paypaaul/Dumb-E/tools/README.md

# Tools

Strumenti lato PC. Previsto per la Fase 2: una CLI Python (pyserial) che parla il
[protocollo seriale](../docs/protocol.md) per script, sequenze e calibrazione.
