paypaaul/Dumb-E/hardware/pcb/SCH_Schematic1_2026-09-24.pdf

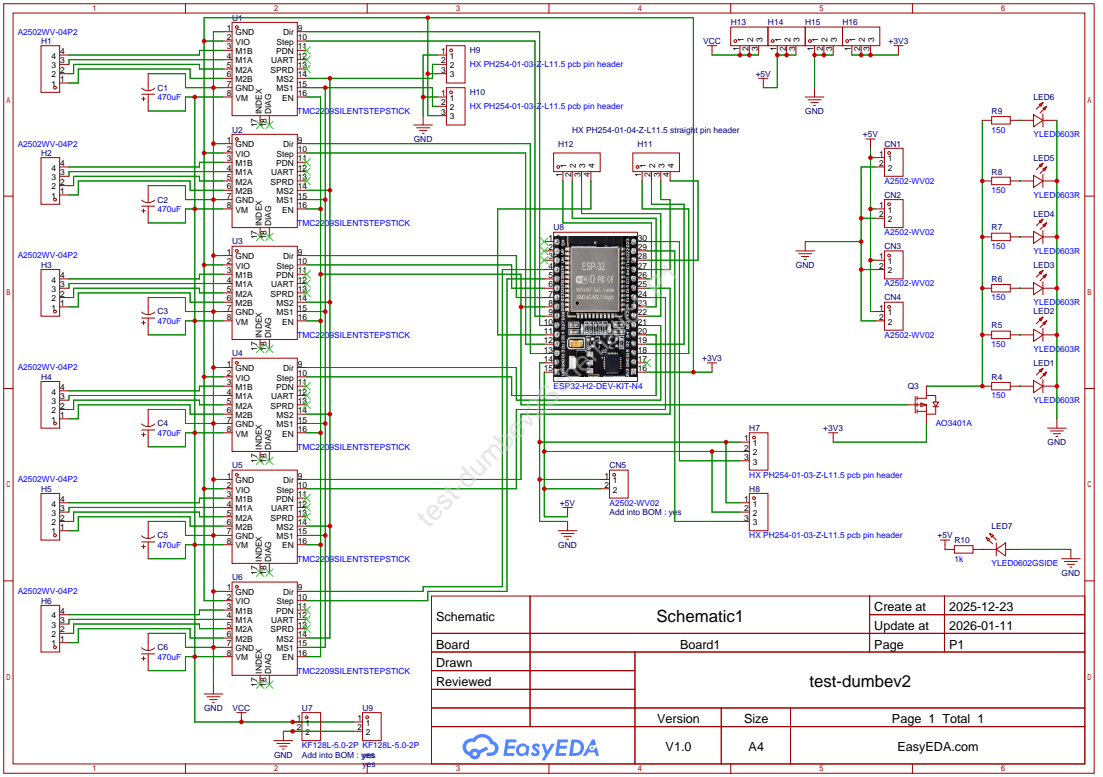
[picture p2: page 1]

HX PH254-01-04-Z-L11.5 straight pin header

Schematic | Schematic1 | Create at | 2025-12-23

Update at | 2026-01-11

Board | Board1 | Page | P1
Drawn | | test-dumbev2
Reviewed

Version | Size | Page 1 Total 1
V1.0 | A4 | EasyEDA.com
