paypaaul/Dumb-E/(list of files, drawings)

Other design files:
hardware/pcb/Board1.epro
