paypaaul/Dumb-E/(commit log)

2026-09-24 Restructure into monorepo and pin the toolchain
    - Move the ESP-IDF project into firmware/ to make room for hardware/, tools/ and docs/.
    - Drop .DS_Store and personal VS Code settings; ignore them from now on.
    - Require CMake 3.22 as the IDF 6 template does, rename the project to dumb_e
    (version comes from git describe) and enable MINIMAL_BUILD.
    - Add sdkconfig.defaults (240 MHz, 4 MB flash, 1 kHz tick, cache-safe GPTimer ISR).
    - Pin the devcontainer to espressif/idf:v6.0.3.
    - Add .clangd pointing at firmware/build, .clang-format and .editorconfig.
    - Add CI: host unit tests and firmware build with ESP-IDF v6.0.3.
2026-09-24 Add pure-C kinematics, motion profiles and step DDA with host tests
    - kinematics: 5-DOF model (base yaw, shoulder, elbow, wrist pitch, wrist roll),
    closed-form FK/IK with explicit elbow up/down, tool length, joint limits,
    singularity/unreachable detection, joint<->step mapping with rounding.
    Units are mm and radians throughout.
    - motion_profile: closed-form trapezoidal/triangular profiles on a path
    parameter, controlled stop, and synchronised limits for multi-joint moves.
    - stepgen_dda: integer-only DDA producing exactly n evenly spaced steps per
    segment; segment_ring: lock-free SPSC ring with C11 atomics.
    - Host test suite (CMake + Unity v2.6.1) covering all of the above.
2026-09-24 Replace the prototype firmware with the layered motion stack
    - stepgen: GPTimer step ISR (40 kHz) allocated on core 1, integer-only,
    cache-safe (IRAM), single-register STEP writes, guaranteed pulse width,
    DIR written one tick ahead, lock-free segment queue, stats and a tick
    watchdog that re-arms the timer if an alarm is ever lost.
    - motion: 1 kHz planner task on core 1 woken by the ISR; synchronised
    trapezoidal joint moves (all joints start and stop together), queued
    commands, controlled stop along the path, abort with resync.
    - robot: DISABLED/ENABLED/READY/ESTOP state machine, manual reference
    (zero at park pose), soft limits, jog, park, optional e-stop input,
    status LED; mec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
    [board.c, board.h, comms.c, comms.h, gripper.c, gripper.h, main.c]
2026-09-24 Add project documentation
    README with build/test instructions and quick start; docs for the
    architecture, serial protocol v0, kinematics conventions and parameters
    to measure, bring-up and bench tests, roadmap, and the review of the
    original prototype. Placeholders for hardware/ and tools/.
2026-09-24 Uploaded PCB files
    [Board1.epro]
2026-09-24 Adopt the test-dumbev2 PCB pinout and add its review
    - board: pin map of the carrier PCB with a DOIT ESP32 DevKit V1 (30 pin):
    J1..J5 on drivers U1..U5, EN on GPIO25, gripper servo on H7 (GPIO23).
    U6 is unusable (STEP/DIR routed to input-only GPIO35/34).
    - stepgen: STEP pins may now be any output GPIO, including 32/33 (U3 STEP
    is on GPIO32), using both the out and out1 set/clear registers.
    - robot: e-stop default moved to GPIO21 (header H12) with the internal
    pull-up enabled when the pin has one.
    - hardware/pcb/REVIEW.md: full review of the PCB (wrong H2 symbol, EN
    without pull-up, GPIO12 strapping, 10 mil link between the motor supply
    terminals, missing input protection, shared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
    [board.c, board.h, robot.c, stepgen.c, stepgen.h]
2026-09-24 Document that the PCB LEDs are not populated
    LED1..7, their resistors and Q3 are indicators only and are not fitted on
    the current board; the netlist confirms nothing else depends on them.
    Update the EN pull-up rework (resistor across the empty Q3 pads, or from
    H16 3V3 to a driver EN pin), the bring-up check (measure EN instead of
    looking at the LEDs), and the next-revision notes (LEDs as DNP, dedicated
    EN pull-up).
2026-09-24 Add draft bill of materials
    PCB parts from the netlist, power parts provided by the user (specs to
    be filled in), actuators and mechanics placeholders, and a first power
    budget estimate.
2026-09-24 Rework kinematics on the real arm geometry from the CAD
    The STEP model shows the joint order base yaw, shoulder pitch, elbow
    pitch, forearm roll, wrist pitch, with the gripper offset 67.4 mm along
    the wrist axis. The previous model (wrist pitch + wrist roll, planar
    tool) did not match.
    - kinematics: new model (d1 104.8, a2 159.2, a3 151.8, tool offset 67.4,
    tool length 155.4 mm). Poses are TCP position + approach direction
    (pitch, yaw). IK: closed form for the arm and wrist given the wrist
    centre, Newton on the wrist centre for the tool offset (seeded from
    the current pose), joint-space Levenberg-Marquardt as last resort,
    always verified with FK.
    - robot/comms: IK seeded with the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
    [board.c, board.h, comms.c, robot.c, robot.h, robot_config.c]
2026-09-24 BOM: add 24 V PSU and 5 V step-down specs, update power budget
2026-09-24 BOM: add IEC C14 mains inlet with switch and fuse
2026-09-24 BOM: add 4010 5 V cooling fans and update the 5 V budget
2026-09-24 Remove the CAD model from the repository
    The cycloidal drives are derived from purchased SweepDynamics models that
    may not be redistributed. Delete hardware/cad/robot.step, ignore CAD files
    under hardware/cad/, and point the docs to the measured values instead.
    BOM: J5 uses a pancake NEMA17; cycloidal hardware comes from the
    SweepDynamics BOM.
2026-09-24 README: add hero image (photo, key specs, kinematic chain)
